qppd/smart-vehicle-impact-detection-device/docs/STACKS.md

# Software Stack & Firmware Architecture
## IoT-Based Vehicle Impact Detection System

---

### 7.1 Firmware Overview

Complete ESP32 firmware for Phase 1 (impact detection → countdown → GPS → SMS). Written as a **single file** (see FIRMWARE.md §8.1) with logically separated sections so it can be split into modules later; Phase 2 extensibility is preserved.

---

### 7.2 Firmware Architecture

> **Logical structure only** — the Phase 1 deliverable is one `.ino`/`.cpp` file
> (FIRMWARE.md §8.1). The diagram shows how the code is organized inside it.

```mermaid
graph TB
    MAIN["main.cpp<br/>setup() / loop()"]
    SM["state_machine"]
    SENSOR["sensor code<br/>MPU6050"]
    IMPACT["impact_detector"]
    COMM["communication code<br/>SIM808"]
    PERIPH["peripherals<br/>LEDs + Buzzer"]
    CONFIG["configuration<br/>(#define block)"]

    MAIN --> SM
    MAIN --> SENSOR
    MAIN --> IMPACT
    MAIN --> COMM
    MAIN --> PERIPH
    SM --> CONFIG
    SENSOR --> CONFIG
    IMPACT --> CONFIG
    COMM --> CONFIG
    PERIPH --> CONFIG
```

---

### 7.3 State Machine

```mermaid
stateDiagram-v2
    [*] --> BOOT
    BOOT --> SELF_TEST : init OK
    BOOT --> ERROR : init FAIL

    SELF_TEST --> MONITORING : sensors OK
    SELF_TEST --> ERROR : sensor FAIL

    MONITORING --> IMPACT_DETECTED : impact detected
    IMPACT_DETECTED --> CONFIRMATION_WINDOW : start countdown

    CONFIRMATION_WINDOW --> GPS_ACQUISITION : timeout 15s
    CONFIRMATION_WINDOW --> MONITORING : cancelled Phase 2

    GPS_ACQUISITION --> SMS_SENDING : fix acquired or timeout
    SMS_SENDING --> EMERGENCY : SMS sent
    EMERGENCY --> MONITORING : reset power cycle
    ERROR --> BOOT : reset
```

---

### 7.4 Software Stack

```mermaid
graph TB
    MCU["ESP32<br/>Xtensa dual-core 240MHz"]
    I2C["Wire.h 400kHz"]
    UART["HardwareSerial UART2<br/>115200 bps"]
    GPIO["digitalWrite/read"]
    TIMING["millis()<br/>Non-blocking"]
    POWER["Boost 3.7V→5V<br/>TP4056"]
    SMS["AT Commands<br/>Text mode"]
    GPS["AT+CGNSINF<br/>NMEA"]

    MCU --> I2C
    MCU --> UART
    MCU --> GPIO
    MCU --> TIMING
    MCU --> POWER
    MCU --> SMS
    MCU --> GPS
```

| Layer | Technology | Notes |
|---|---|---|
| MCU | ESP32 38-pin Development Board with Terminal Block (Xtensa dual-core, 240 MHz) | FPU available |
| I²C | Wire.h (400 kHz) | MPU6050 on GPIO21/22 |
| UART | HardwareSerial (UART2, GPIO16/17) | SIM808 at 115200 bps |
| GPIO | digitalWrite/read | LEDs, buzzer |
| Timing | millis() | Non-blocking |
| Power | Boost 3.7V→5.0V, TP4056 charger | See SYSTEM-ARCHITECTURE |
| SMS | SIM808 AT commands (text mode) | AT+CMGF=1, AT+CMGS |
| GPS | SIM808 AT+CGNSINF | NMEA or parsed response |

---

### 7.5 Configuration (config.h)

```cpp
// GPIO Assignments — VERIFY WITH YOUR BOARD!
#define PIN_MPU6050_SDA       21
#define PIN_MPU6050_SCL       22
#define PIN_SIM808_RXD        16   // ESP32 UART2 RX
#define PIN_SIM808_TXD        17   // ESP32 UART2 TX
#define PIN_GREEN_LED         18
#define PIN_RED_LED           19
#define PIN_BUZZER            25

// MPU6050 Settings
#define MPU6050_ADDR          0x68
#define MPU6050_ACCEL_FS      3    // ±16g
#define MPU6050_ACCEL_LSB_G   2048.0
#define MPU6050_SAMPLE_MS     10   // 100 Hz

// Impact Detection
#define IMPACT_THRESHOLD_G    2.5      // Dynamic g (tune via calibration)
#define IMPACT_PERSISTENCE    3        // Consecutive samples
#define IMPACT_COOLDOWN_MS    3000     // ms

// System Timing
#define CONFIRMATION_WINDOW_MS  15000  // 15 seconds
#define GPS_TIMEOUT_MS          30000  // 30 seconds
#define SMS_TIMEOUT_MS          10000  // 10 seconds
#define SMS_RETRY_COUNT         3

// Emergency SMS
#define EMS_PHONE_NUMBER      "+63XXXXXXXXXX"  // <-- USER MUST CONFIGURE!
#define SMS_MAX_LENGTH        160

// LED/Buzzer
#define BUZZER_ACTIVE_HIGH    true
#define LED_ACTIVE_HIGH       true
```

---

### 7.6 Sensor Module (MPU6050)

**Functions:**
- `initMPU6050()` — Wake sensor, set ±16g FSR, 100 Hz sample rate, verify WHO_AM_I = 0x68
- `readMPU6050()` — Read x/y/z acceleration (16-bit → float g)
- `calibrateBias()` — Averages 100 stationary readings (device level, in its
  final mounting orientation) and stores **sensor offsets only**: measured mean
  minus the expected 1 g on Z, so gravity is preserved and the magnitude at rest
  reads ~1.0 g

**Impact Detection:**
```cpp
bool detectImpact() {
  if (millis() - lastImpactTime < IMPACT_COOLDOWN_MS) {
    impactConsecutiveCount = 0;
    return false;
  }
  
  // dynamicMagnitude = |√(x²+y²+z²) − 1 g|, computed in readMPU6050()
  float dynamicMag = accelData.dynamicMagnitude;
  
  if (dynamicMag > IMPACT_THRESHOLD_G) {
    impactConsecutiveCount++;
    if (impactConsecutiveCount >= IMPACT_PERSISTENCE) {
      lastImpactTime = millis();
      impactConsecutiveCount = 0;
      return true;
    }
  } else {
    impactConsecutiveCount = 0;
  }
  return false;
}
```

---

### 7.7 Communication Module (SIM808)

**AT Command Sequence:**
1. `AT` → OK (basic test)
2. `ATE0` → OK (disable echo)
3. `AT+CPIN?` → +CPIN: READY
4. `AT+CREG?` → registered
5. `AT+CMGF=1` → OK (text mode SMS)
6. `AT+CGNSPWR=1` → OK (GPS on)
7. `AT+CGNSINF` → parse latitude/longitude

**SMS Sending:**
```
AT+CMGF=1
AT+CMGS="+63XXXXXXXXXX"
> EMERGENCY ALERT...
[Ctrl+Z]
+CMGS: <ref>
OK
```

---

### 7.8 MPU6050 Guide

See full guide in original documentation set:
- Accelerometer fundamentals (±2g/±4g/±8g/±16g)
- Gravity component removal
- Dynamic magnitude: √(x² + y² + z²) - 1g
- Threshold with persistence check (3 samples)
- Cooldown period (3s)
- Calibration procedure (scenario table in TESTING.md §9.5)
- False positive reduction strategies

---

### 7.9 SIM808 GPS Guide

**GPS Initialization:**
```
AT+CGNSPWR=1          // Enable GPS power
AT+CGNSSEQ="RMC"      // Set NMEA output (optional)
// Wait for fix (firmware polls every 2s)
AT+CGNSINF            // Get GPS info
```

**Parsing AT+CGNSINF:**
```
+CGNSINF: <run_status>,<fix_status>,<utc>,<lat>,<lon>,<alt>,<speed>,<course>,<fix_mode>,...
```
- fix_status = 1 → valid fix
- lat/long in DD.dddddd format

**Timeout:** firmware allows 30 s total, polling every 2 s (up to 10 polls).
Manufacturer-typical TTFF: ~30 s cold start, ~1 s hot start (**UNVERIFIED for
this build**) — the GPS is powered at boot so fixes are normally warm by alert time.

**No-fix handling:** Send SMS containing "GPS unavailable (no fix)".

---

### 7.10 SIM808 SMS Guide

**Prerequisites:**
- SIM registered (AT+CPIN? = READY)
- Network registered (AT+CREG? = 0,1 or 0,5)
- Signal strength (AT+CSQ) > 10

**Configuration:**
- Text mode: AT+CMGF=1
- GSM charset: AT+CSCS="GSM"
- Recipient configurable via EMS_PHONE_NUMBER

**Message Format:**
```
EMERGENCY ALERT: possible vehicle impact.
Lat: <lat>, Lon: <lon>
https://maps.google.com/?q=<lat>,<lon>
```
(≤160 characters — sent as a single SMS; the maps link is never truncated)

**GPS Unavailable:**
```
EMERGENCY ALERT: possible vehicle impact.
Location: GPS unavailable (no fix)
Please check the vehicle/occupant.
```

**Retry:** 3 attempts, 2 s delay between retries (matches firmware).

---

### 7.11 Peripherals

```mermaid
graph LR
    GREEN["🟢 Green LED<br/>GPIO18"] --> MONITOR["MONITORING"]
    RED["🔴 Red LED<br/>GPIO19"] --> IMPACT["IMPACT/EMERGENCY"]
    BUZZ["🔊 Buzzer<br/>GPIO25"] --> PATTERN["Patterns"]

    PATTERN --> P1["Pattern 1<br/>Impact warning"]
    PATTERN --> P2["Pattern 2<br/>Confirmation"]
    PATTERN --> P3["Pattern 3<br/>Emergency"]
```

| Peripheral | GPIO | Behavior |
|---|---|---|
| Green LED | GPIO18 | ON = MONITORING |
| Red LED | GPIO19 | ON = IMPACT/EMERGENCY |
| Buzzer | GPIO25 | Active HIGH; patterns: 1=warning, 2=confirm, 3=emergency |

**Buzzer Patterns:**
- Pattern 1 (impact warning): Single 100ms beep
- Pattern 2 (reserved — the confirmation window uses an inline 50 ms chirp once per second with a 500 ms LED flash)
- Pattern 3 (emergency): Long-short-long (300-100-300ms), repeated every 5 s

---

### 7.12 Timing Design

- State-machine timing is `millis()`-based (countdown, GPS/SMS timeouts, LED flash)
- Blocking `delay()` still exists inside beep patterns, AT-command waits, and the
  2 s SMS retry pause (documented, acceptable for this prototype)
- Sensor read every 10ms (100 Hz) with hardware DLPF (≈92 Hz) filtering
- SIM808 sub-states with 2 s GPS polling interval
- Countdown logged once per second (`[CONFIRM] n s remaining`)

---

### 7.13 Phase 2 Software Extension Points

```mermaid
graph TB
    PHASE1["Phase 1 Core"]
    BTN["Push Button<br/>GPIO4"]
    VOICE["Voice Module<br/>I²C 0x30"]
    ADC["Battery Monitor<br/>ADC GPIO34"]

    PHASE1 --> BTN
    PHASE1 --> VOICE
    PHASE1 --> ADC
```

| Feature | GPIO | Interface | Integration Point |
|---|---|---|---|
| Push button | GPIO4 | Input (internal pull-up) | CONFIRMATION_WINDOW handler |
| Voice module | I²C (addr 0x30) | I²C command read | CONFIRMATION_WINDOW handler |
| Battery monitor | ADC (GPIO34) | Voltage divider | State entry/loop |
| SMS config | UART (existing) | AT command parser | SMS module |

---

### 7.14 Build Instructions

**Arduino IDE:**
1. Install ESP32 board package (Espressif)
2. Select "ESP32 Dev Module"
3. Set upload speed 921600
4. Compile and upload

**PlatformIO:**
```ini
[env:esp32dev]
platform = espressif32
board = esp32dev
framework = arduino
monitor_speed = 115200
```

**Before upload:**
- Set `EMS_PHONE_NUMBER` in config.h
- Verify GPIO assignments match your board
- Install MPU6050 library (or use raw Wire.h)

---

### 7.15 Troubleshooting Software

| Symptom | Check |
|---|---|
| MPU6050 WHO_AM_I ≠ 0x68 | I²C wiring, pull-ups, address |
| SIM808 AT no response | UART baud, VMCU level, power |
| GPS no fix | Antenna, sky view, CGNSPWR=1 |
| SMS not sent | Network, SIM balance, CMGF=1 |
| Impact not detected | Threshold too high, recalibrate |
| False positives | Threshold too low, increase persistence |
| System hangs | Blocking delay, WDT reset |
| Buzzer silent | Active vs passive, wiring |

---

### 7.16 Summary

- Clear state machine with 9 states
- Modular architecture (sensor, communication, peripheral modules)
- millis()-based state timing (blocking waits remain in AT/beep helpers)
- Configurable parameters in config.h
- Boot-time fault detection → ERROR state; runtime SMS failures are logged
- Phase 2 extension points documented
