qppd/smart-vehicle-impact-detection-device/model/1.png

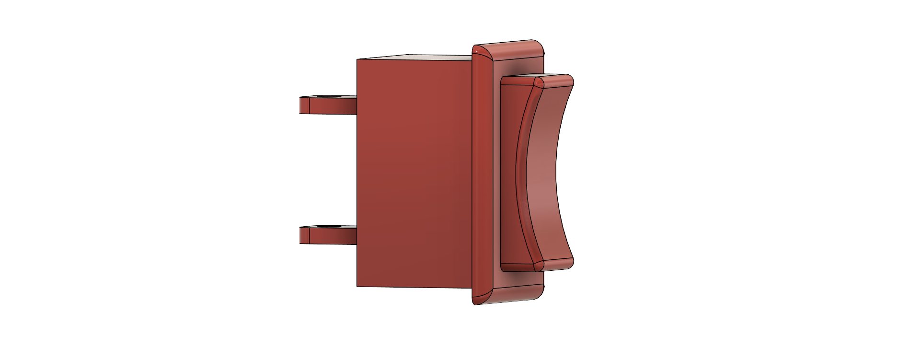
model/1.png
