qppd/smart-vehicle-impact-detection-device/model/2.png

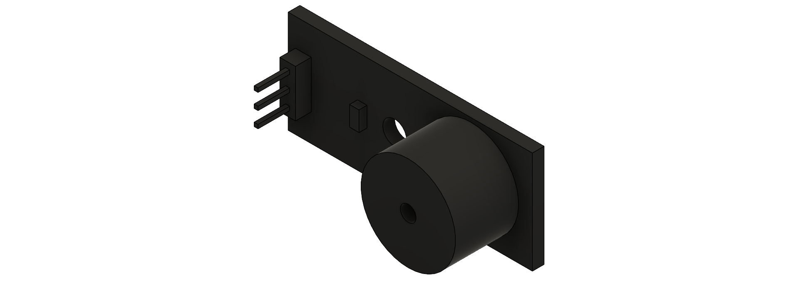
model/2.png
