qppd/smart-vehicle-impact-detection-device/model/3.png

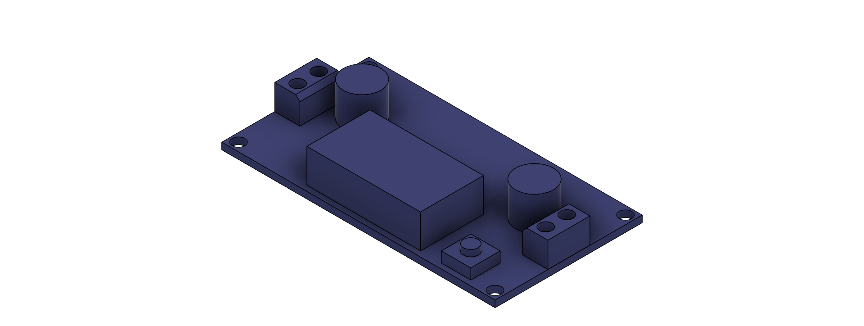
model/3.png
