qppd/smart-vehicle-impact-detection-device/model/4.png

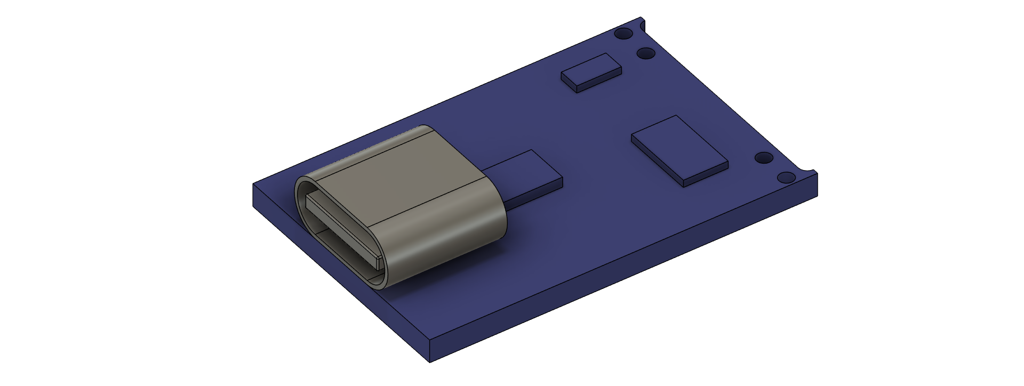
model/4.png
