qppd/smart-vehicle-impact-detection-device/model/5.png

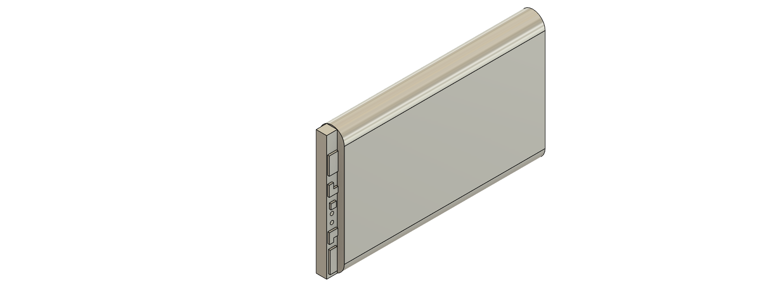
model/5.png
