qppd/smart-vehicle-impact-detection-device/model/7.png

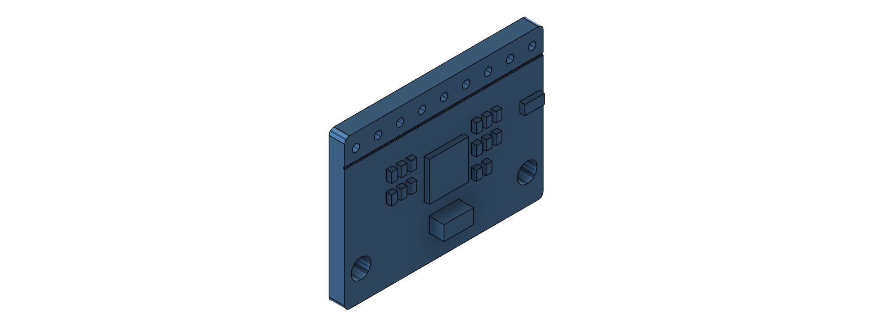
model/7.png
