qppd/smart-vehicle-impact-detection-device/model/9.png

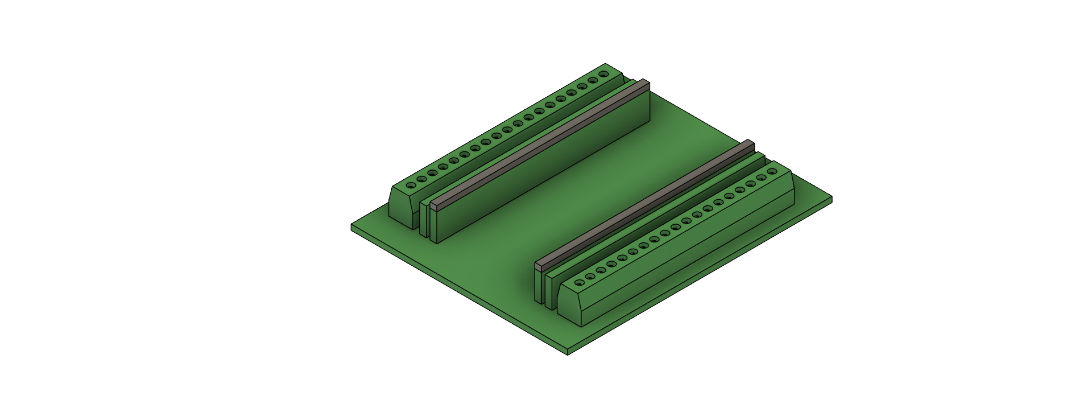
model/9.png
