qppd/smart-vehicle-impact-detection-device/model/Vehicle_Impact_Detection_Device_3D_Model_2.png

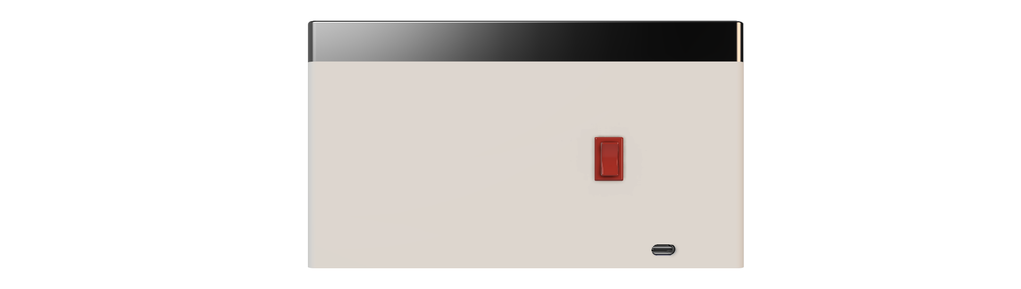
model/Vehicle_Impact_Detection_Device_3D_Model_2.png
