qppd/smart-vehicle-impact-detection-device/model/Vehicle_Impact_Detection_Device_3D_Model_6.png

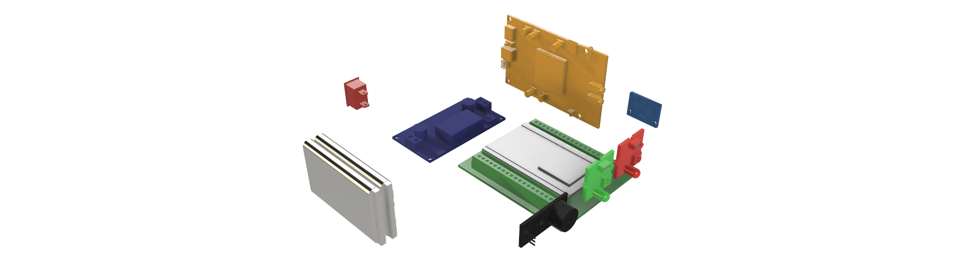
model/Vehicle_Impact_Detection_Device_3D_Model_6.png
