qppd/smart-vehicle-impact-detection-device/(list of files, cad)

Other CAD files:
model/Vehicle_Impact_Detection_Device_Fusion_360_File.f3z
