qppd/smart-vehicle-impact-detection-device/(commit log)

2026-10-06 Add 1000uF 25V capacitor for SIM808 power decoupling; update BOM and wiring docs
2026-10-06 Update diagrams to show 1000uF capacitor at SIM808 power input
2026-10-06 Fix mermaid diagram syntax in WIRING.md voltage compatibility check
2026-10-06 Fix Mermaid cycle error in signal flow diagram (GPS node redefined as subgraph)
2026-10-08 Add C103 car charger to BOM, remove resettable fuse from power path
    - BOM: add HBK Travel Car Charger (C103 TYPE-C variant) as the 5V source feeding the TP4056 Type-C port; renumber items 18-20.
    - Remove the 3A resettable fuse everywhere (BOM, SETUP, WIRING, BLOCK-DIAGRAM, SYSTEM-ARCHITECTURE): BAT+ now runs pack -> SW1 -> TP4056 B+/SIM808 BAT+. WIRING power table renumbered P1-P11 and the mermaid diagram renumbered to match (fixes an off-by-one vs the table).
    - SETUP: in-vehicle charging step (Step 7), USB-C access note, FAQ entry; TROUBLESHOOTING: car-charger causes for 'TP4056 not charging'.
    - Prior session edits included: firmware (GPS powered at boot, countdown serial log, green LED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
2026-10-09 Added all 3D models
    [Vehicle_Impact_Detection_Device_Fusion_360_File.f3z]
2026-10-09 Update ESP32 specification to ESP32 38-pin Development Board with Terminal Block; remove status line from README
